K4PER-PEAR/POWER_GBC/schematic_revC0.pdf

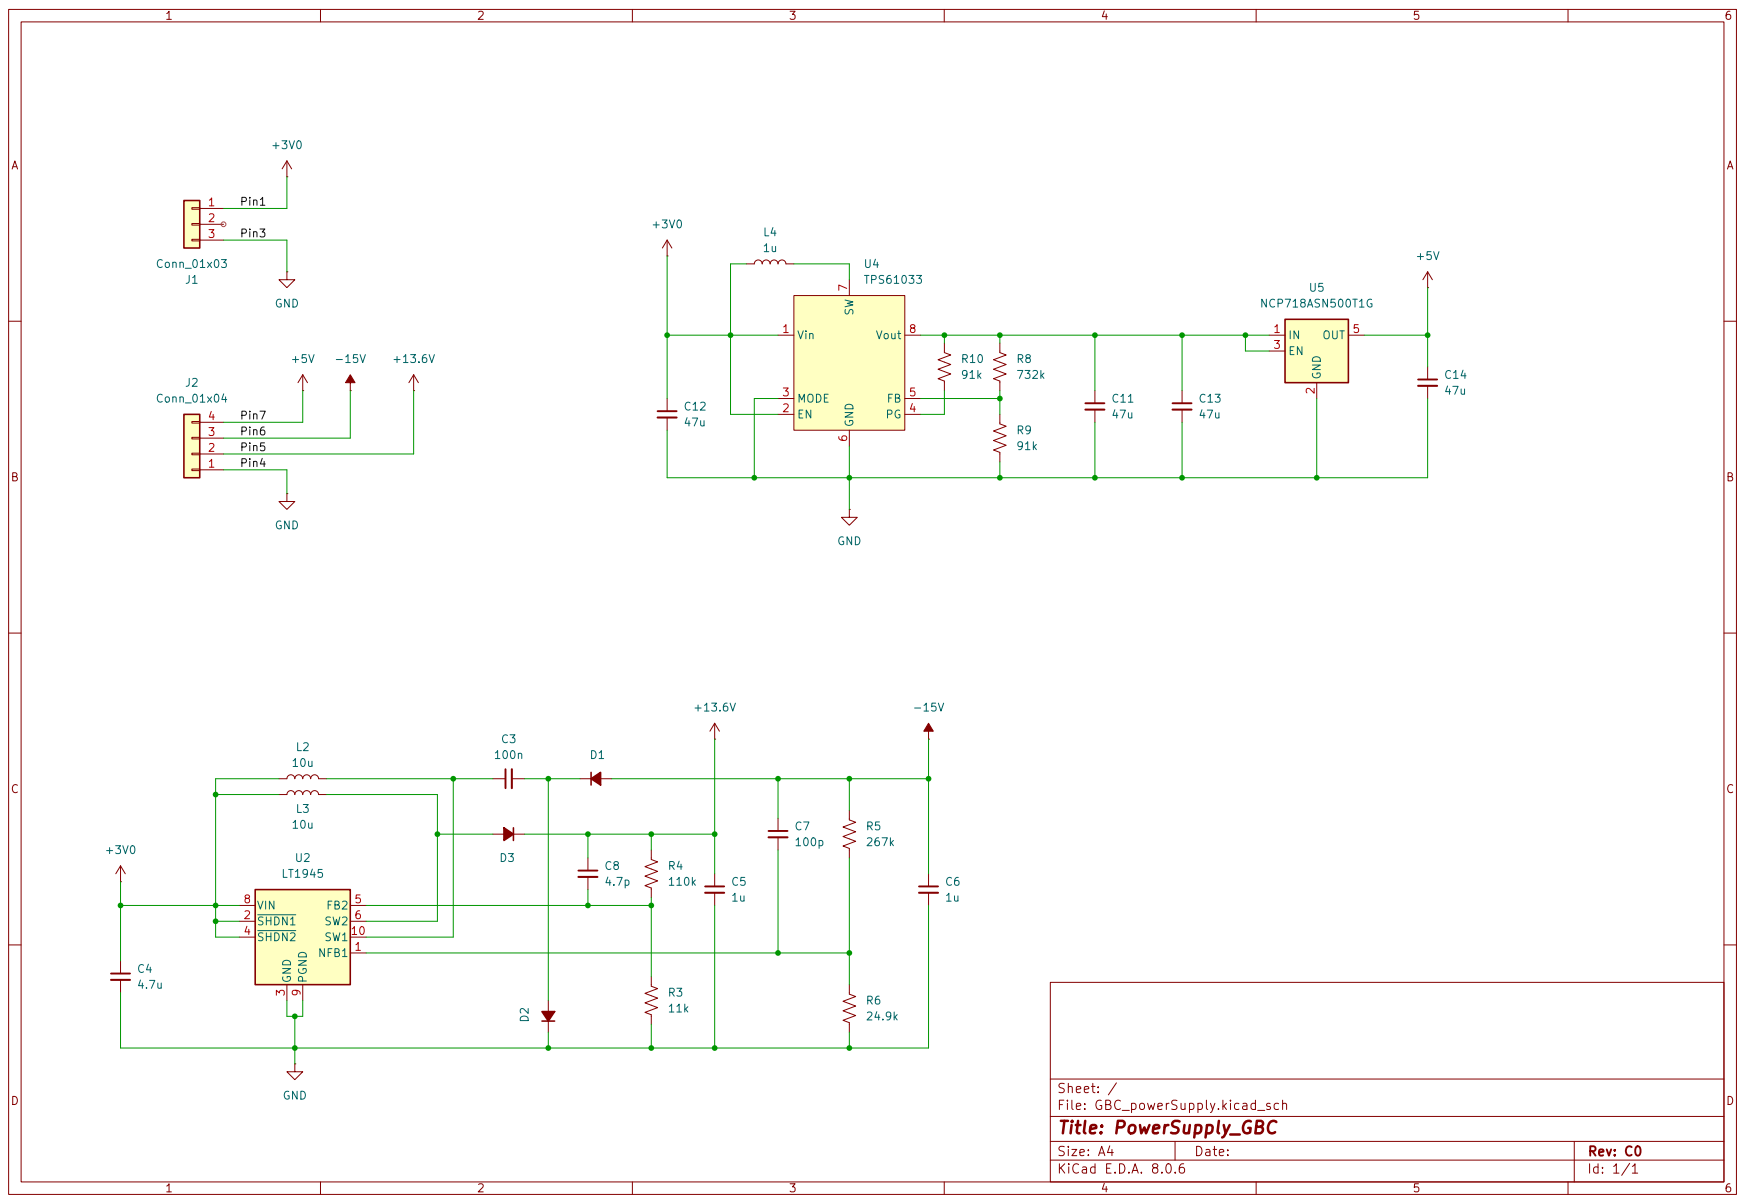
[picture p4: page 1]
