K4PER-PEAR/POWER_GBC/(commit log)

2024-12-29 Add gerber files for rev C0 build
    These are the gerber files used to order board from OSH Park.
2024-12-29 Add schematic
2024-12-29 Add component BOM
    [BOM_revC0.csv]
2024-12-29 Add schematic images for readme
2024-12-30 add schematic as pdf
